cese-dci/tp-dci--JhonattanCamargo/doc/1. Asignación de Pines.png

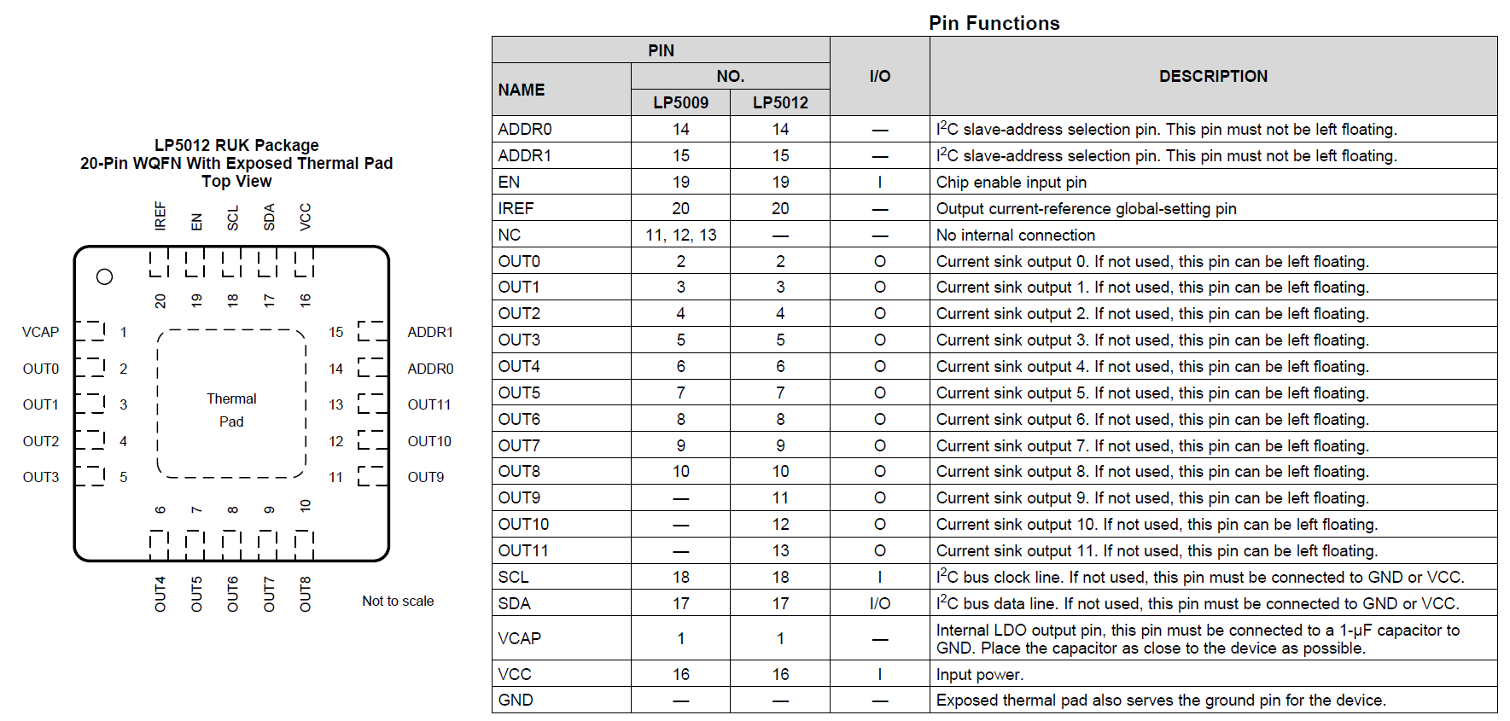
doc/1. Asignación de Pines.png
