cese-dci/tp-dci--JhonattanCamargo/doc/2. Dibujos mecánicos A.png

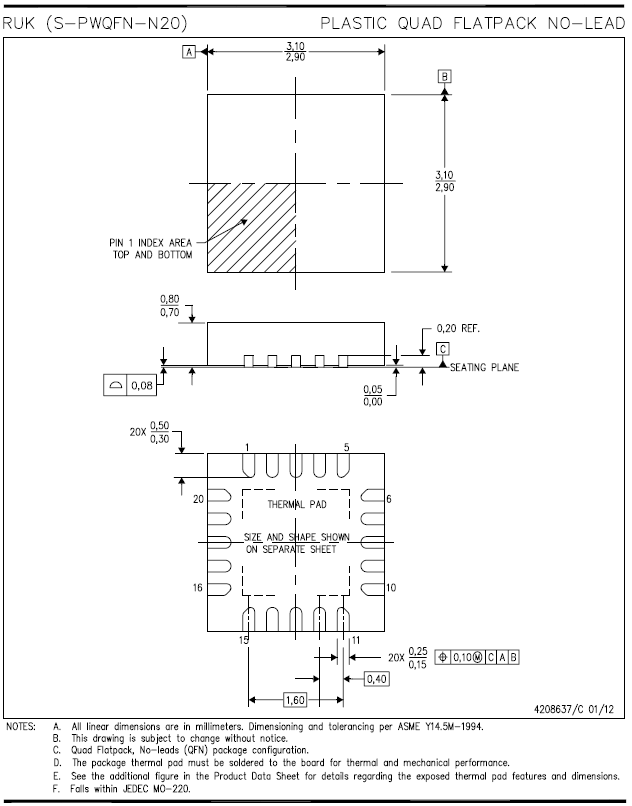
doc/2. Dibujos mecánicos A.png
