cese-dci/tp-dci--JhonattanCamargo/doc/2. Dibujos mecánicos B.png

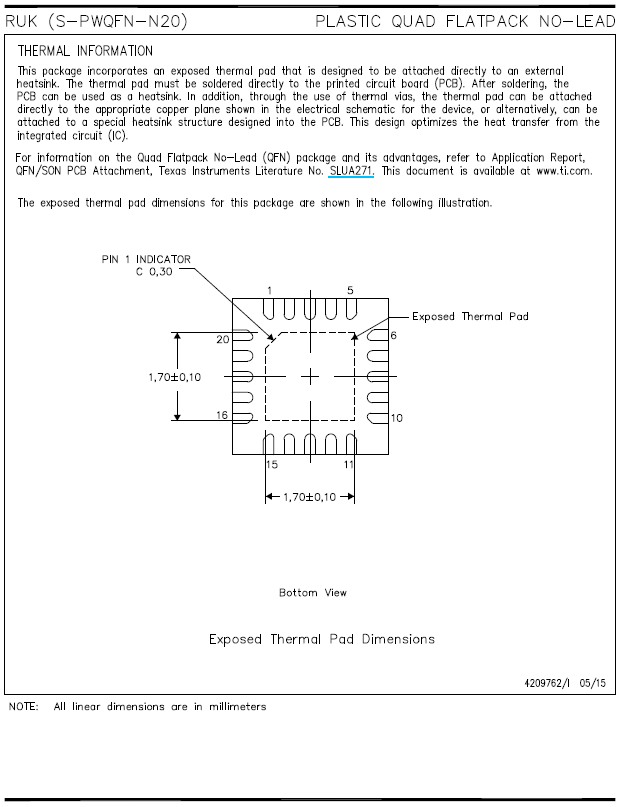
doc/2. Dibujos mecánicos B.png
