cese-dci/tp-dci--JhonattanCamargo/doc/3. Huella recomendada.png

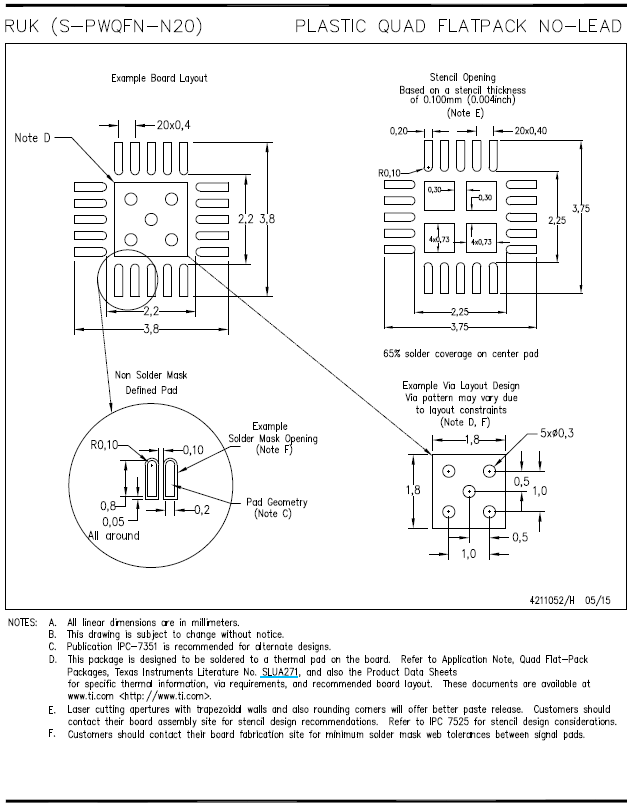
doc/3. Huella recomendada.png
