cese-dci/tp-dci--JhonattanCamargo/doc/4. Configuración de corriente de led.png

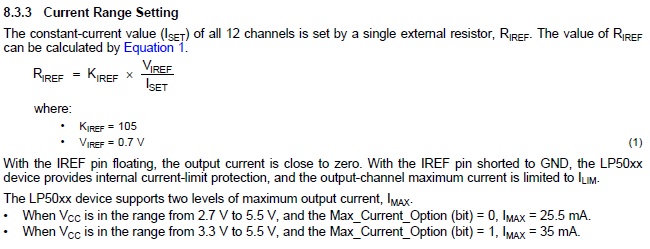
doc/4. Configuración de corriente de led.png
