cese-dci/tp-dci--JhonattanCamargo/pcb/Renders/Board Bottom First Render.jpg

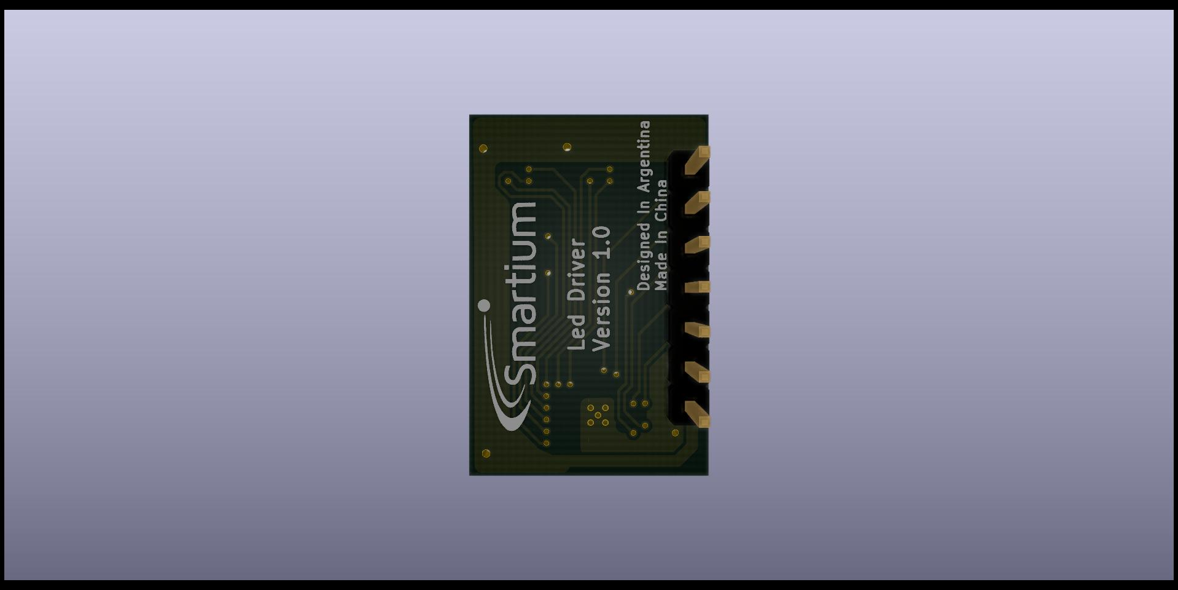
pcb/Renders/Board Bottom First Render.jpg
