cese-dci/tp-dci--JhonattanCamargo/pcb/Renders/Board Top First Render.jpg

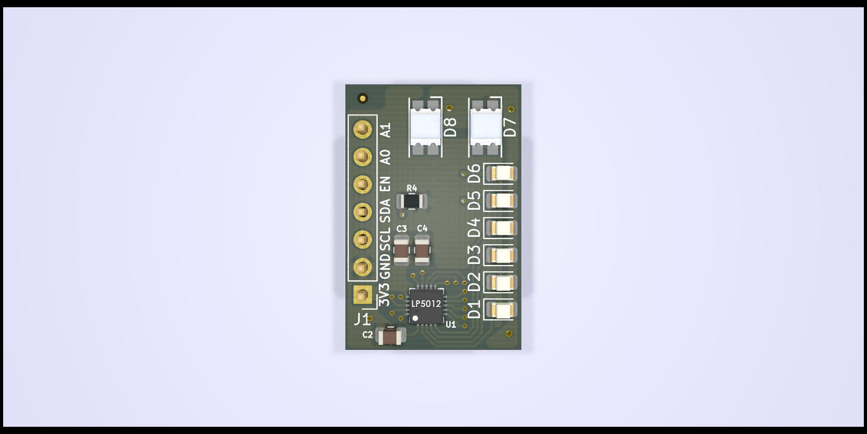
pcb/Renders/Board Top First Render.jpg
