cese-dci/tp-dci--JhonattanCamargo/pcb/3dshapes/LED1210.SLDPRT

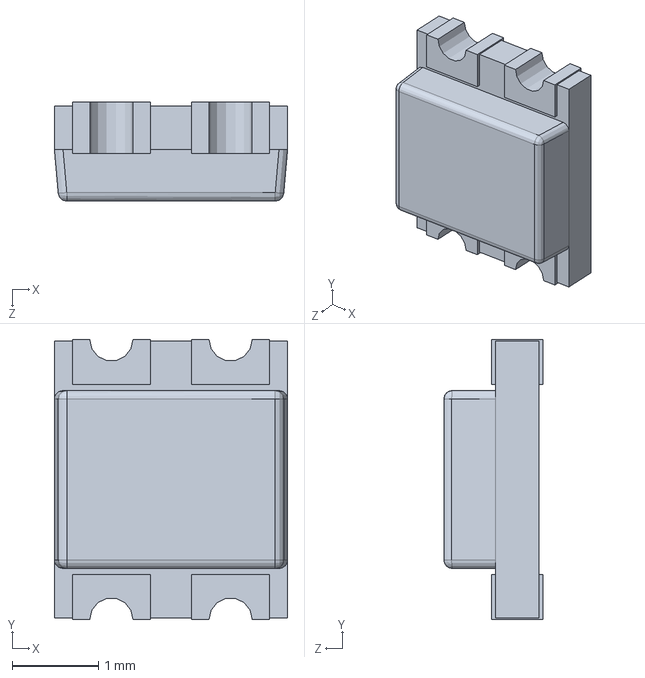
[picture p10: CAD file, 2019-10-13]
pcb/3dshapes/LED1210.SLDPRT
2.70 x 3.24 x 1.15 mm
