cese-dci/tp-dci--JhonattanCamargo/pcb/3dshapes/LP5012.SLDPRT

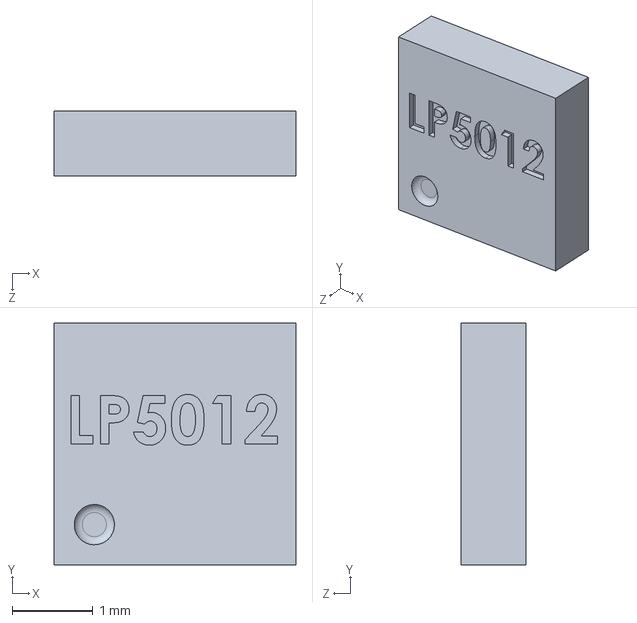
[picture p11: CAD file, 2019-10-13]
pcb/3dshapes/LP5012.SLDPRT
3.00 x 3.00 x 0.8 mm
