cese-dci/tp-dci--JhonattanCamargo/pcb/LP5012.kicad_pcb

## KiCad design pcb/LP5012.kicad_pcb (2019-10-26)

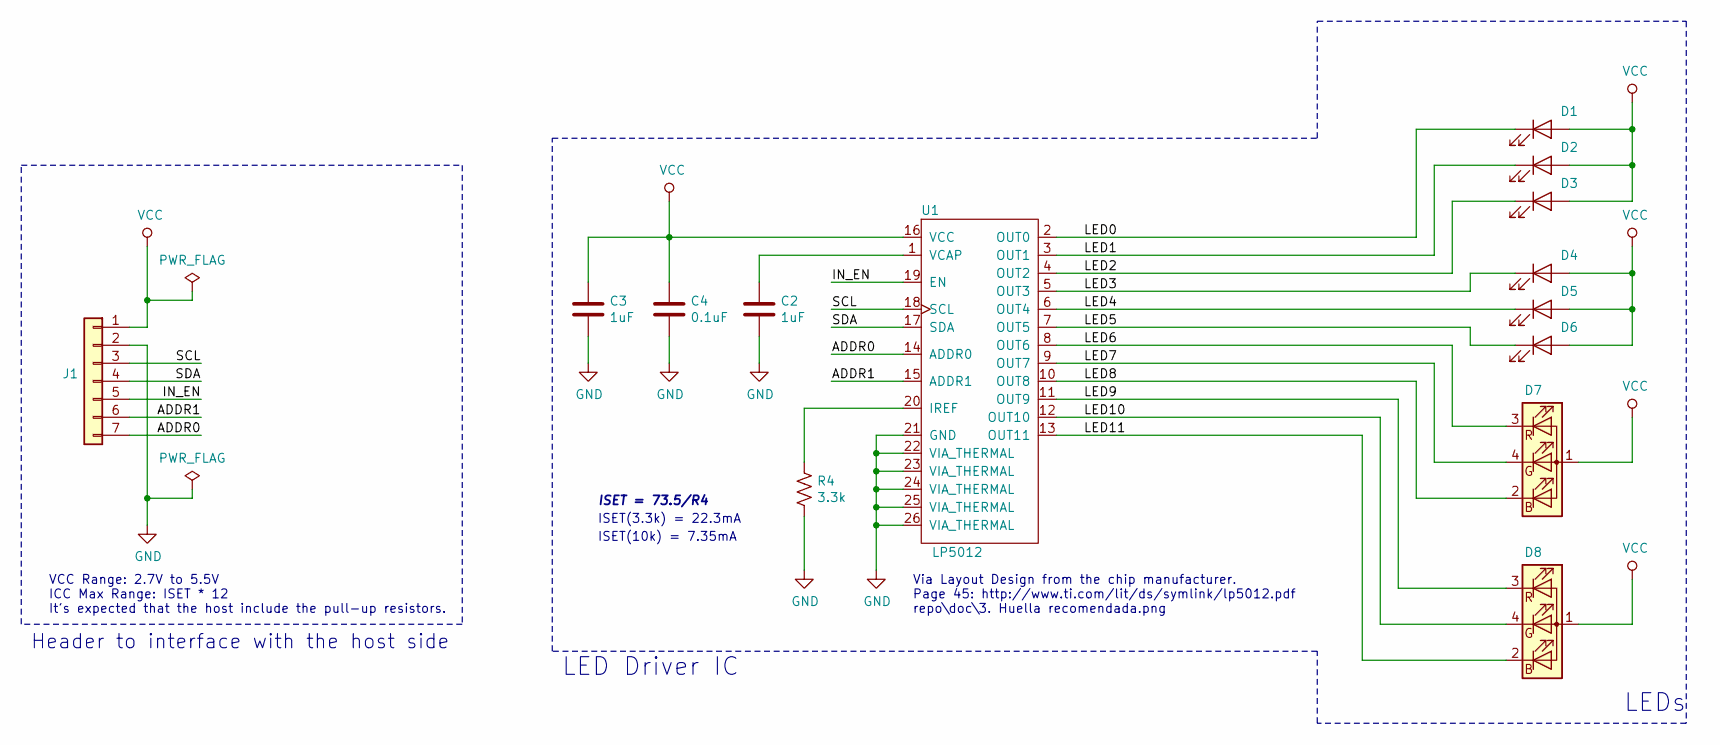
[picture p12: schematic LP5012.sch, LP5012 Custom PCB]

Parts:
C2, C3: 1uF; C_0805_2012Metric
C4: 0.1uF; C_0805_2012Metric
D1, D2, D3, D4, D5, D6: LED; LED_0805_2012Metric
D7, D8: LED_RGB; LED_RGB_1210_with3DShape
J1: Main Connector; PinHeader_1x07_P2.54mm_Vertical
R4: 3.3k; R_0805_2012Metric
U1: LP5012

Connections:
/ADDR0: J1.7, U1.14 (ADDR0)
/ADDR1: J1.6, U1.15 (ADDR1)
/IN_EN: J1.5, U1.19 (EN)
/LED0: D1.1 (K), U1.2 (OUT0)
/LED1: D2.1 (K), U1.3 (OUT1)
/LED2: D3.1 (K), U1.4 (OUT2)
/LED3: D4.1 (K), U1.5 (OUT3)
/LED4: D5.1 (K), U1.6 (OUT4)
/LED5: D6.1 (K), U1.7 (OUT5)
/LED6: D7.3 (RK), U1.8 (OUT6)
/LED7: D7.4 (GK), U1.9 (OUT7)
/LED8: D7.2 (BK), U1.10 (OUT8)
/LED9: D8.3 (RK), U1.11 (OUT9)
/LED10: D8.4 (GK), U1.12 (OUT10)
/LED11: D8.2 (BK), U1.13 (OUT11)
/SCL: J1.3, U1.18 (SCL)
/SDA: J1.4, U1.17 (SDA)
GND: C2.2, C3.2, C4.2, J1.2, R4.2, U1.21 (GND), U1.22 (VIA_THERMAL), U1.23 (VIA_THERMAL), U1.24 (VIA_THERMAL), U1.25 (VIA_THERMAL), U1.26 (VIA_THERMAL)
unnamed: C2.1, U1.1 (VCAP)
unnamed: R4.1, U1.20 (IREF)
VCC: C3.1, C4.1, D1.2 (A), D2.2 (A), D3.2 (A), D4.2 (A), D5.2 (A), D6.2 (A), D7.1 (A), D8.1 (A), J1.1, U1.16 (VCC)

Notes on the sheet:
Via Layout Design from the chip manufacturer. Page 45: http://www.ti.com/lit/ds/symlink/lp5012.pdf repo\doc\3. Huella recomendada.png
VCC Range: 2.7V to 5.5V ICC Max Range: ISET * 12 It's expected that the host include the pull-up resistors.
ISET = 73.5/R4
ISET(3.3k) = 22.3mA
Header to interface with the host side
LED Driver IC
LEDs
ISET(10k) = 7.35mA

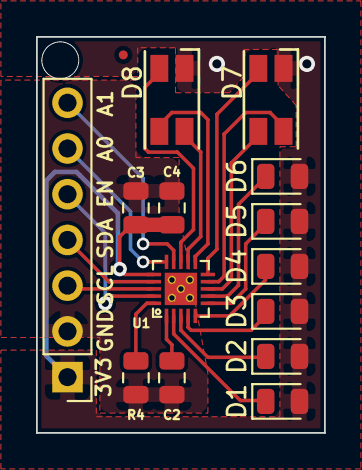
[picture p13: board LP5012.kicad_pcb from above]

Board: 2 copper layers, 16.0 x 22.0 mm, 15 parts (0 on the bottom side), 21 nets.

Other parts of the board:
FD1: Fiducial_0.5mm_Mask1mm
