cese-dci/tp-dci--JhonattanCamargo/(commit log)

2019-10-01 Inclusión de Esquemático V1
    [LP5012EVM.kicad_pcb, LP5012EVM.sch]
2019-10-04 Inclusión de la versión custom que se fabricará para el proyecto final
    [LP5012EVM.sch, LP5012EVM_Original.sch]
2019-10-04 Inclusion de datasheet del chip y otros archivos
    [LP5012EVM_Original.sch]
2019-10-04 Corrección de errores y actualizacion de nombres
    [LP5012EVM_Custom.sch, LP5012EVM_Replica.sch]
2019-10-05 Corregidos algunos aspectos del revisor
    [LP5012EVM.kicad_pcb, LP5012EVM_Custom.kicad_pcb, LP5012EVM_Custom.sch]
2019-10-06 Inclusion de PCB
    [LP5012EVM.kicad_pcb, LP5012EVM.sch, LP5012EVM_Custom.kicad_pcb]
2019-10-06 Avance de ruteo
    [LP5012EVM.kicad_pcb]
2019-10-12 Inclusión de avance de PCB
    Inclusión de planos, queda pendiente agregar modelos 3D de agunos componentes
    [LP5012EVM.kicad_pcb, LP5012EVM.sch]
2019-10-12 Corrección de DRCs
    [LP5012EVM.kicad_pcb]
2019-10-12 Inclusión de algunos aspectos de la corrección del compañero
    [LP5012EVM.kicad_pcb, LP5012EVM.sch]
2019-10-13 Depuración de archivos sobrantes y estructuración de carpetas
    Se añaden carpetas doc, info y pcb.
    Se limpian archivos que estaban de más.
    [LP5012.kicad_pcb, LP5012.sch, LP5012EVM_Replica.sch]
2019-10-13 Creación de Readme.md
2019-10-13 Create Link a la planilla de calificación.md
2019-10-13 Inclusión de modelos 3D y modificación de algunas liberías
    [LED1210.SLDPRT, LP5012.SLDPRT, LP5012.kicad_pcb, LP5012.sch]
2019-10-13 Inclusión de renders
2019-10-19 Ligeras modificaciones estéticas
    [LP5012.kicad_pcb]
2019-10-19 Inlcusión de notas de fabricación
    [LP5012.kicad_pcb]
2019-10-19 Update LP5012.kicad_pcb-bak
2019-10-19 Inclusión de cambios de revisión 2
    [LP5012.kicad_pcb, LP5012.sch]
2019-10-19 Ultimas modificaciones
    [LP5012.kicad_pcb, LP5012.sch]
2019-10-26 Inclusión del agujero requerido
    Inclusión de agujero para sujeción M2
    [LP5012.kicad_pcb]
